hfcteac/Graduation-project-Design-of-intelligent-building-security-system-based-on-STM32-cloud-platform-2/README.md

# Graduation-project-Design-of-intelligent-building-security-system-based-on-STM32-cloud-platform-2
C:\Users\hafeizhou\Desktop\jswjj\Graduation-project-Design-of-intelligent-building-security-system-based-on-STM32-cloud-platform-2
