hfcteac/Graduation-project-Design-of-intelligent-building-security-system-based-on-STM32-cloud-platform-2/face/5B接线图.png

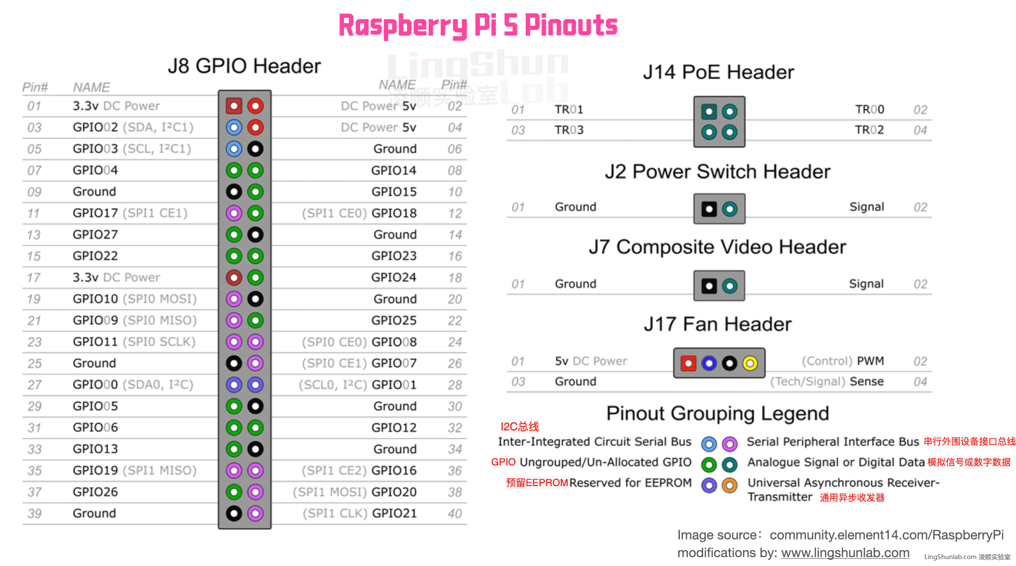
face/5B接线图.png
