hfcteac/Graduation-project-Design-of-intelligent-building-security-system-based-on-STM32-cloud-platform-2/face/known_faces/sn.jpg

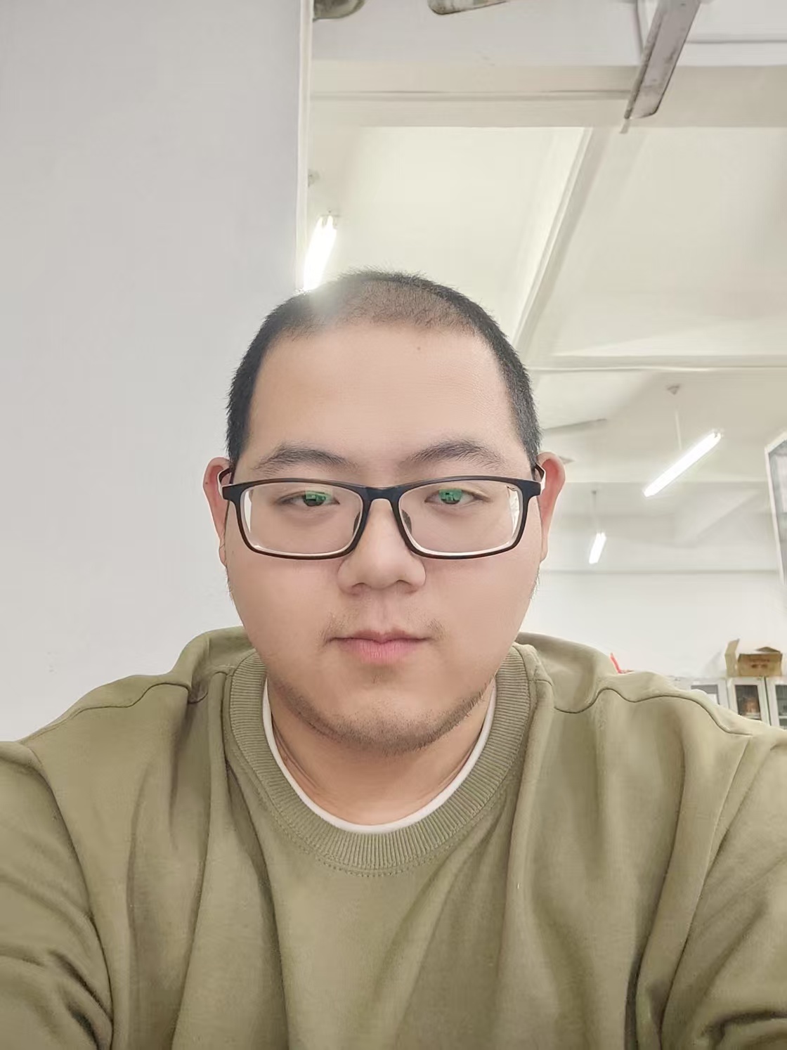
face/known_faces/sn.jpg
