hfcteac/Graduation-project-Design-of-intelligent-building-security-system-based-on-STM32-cloud-platform-2/vet6/44c06ee67584bbd57bad9b7da9e677ca.jpg

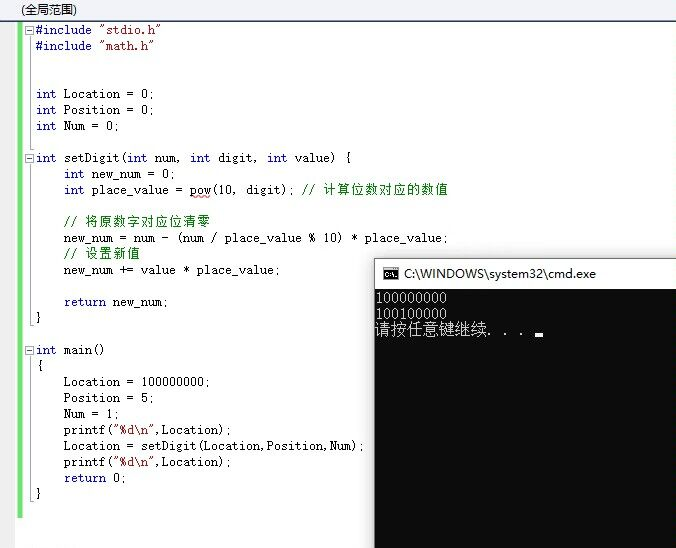
vet6/44c06ee67584bbd57bad9b7da9e677ca.jpg
