hfcteac/Graduation-project-Design-of-intelligent-building-security-system-based-on-STM32-cloud-platform-2/vet6/GCLQ(KQY%EE(XPK2@BC}B]3.png

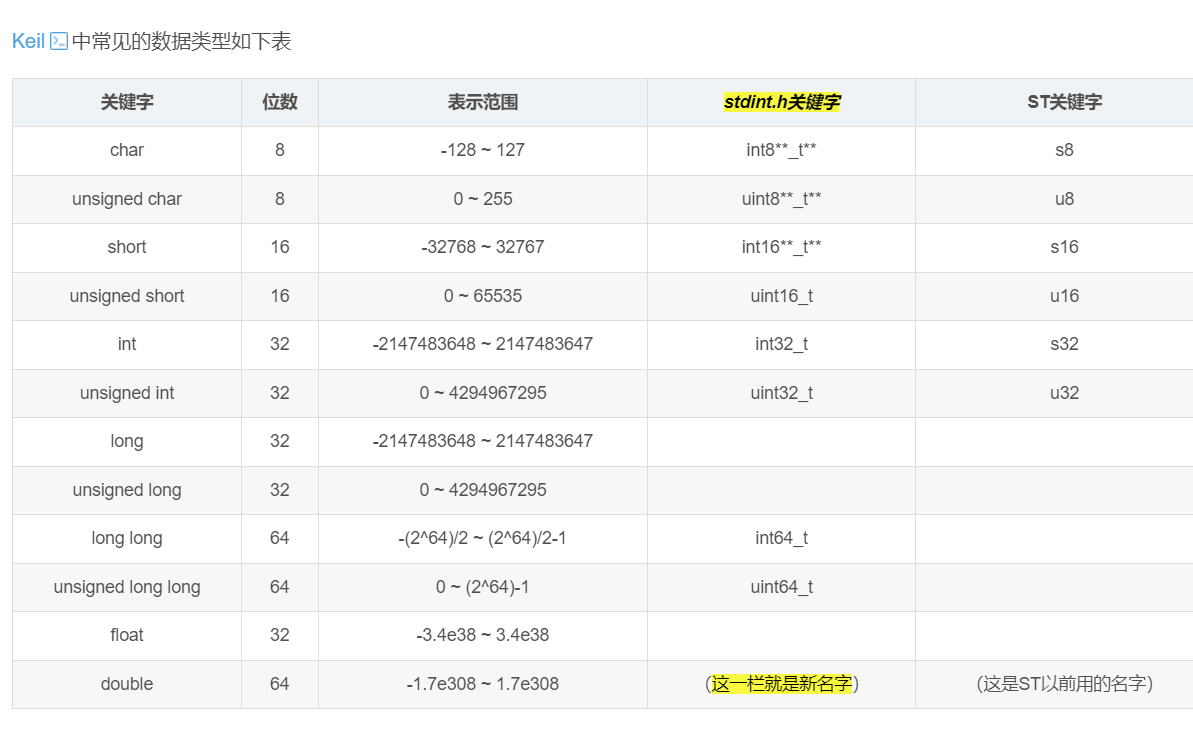
vet6/GCLQ(KQY%EE(XPK2@BC}B]3.png
