hfcteac/Graduation-project-Design-of-intelligent-building-security-system-based-on-STM32-cloud-platform-2/vet6/oeld取模.png

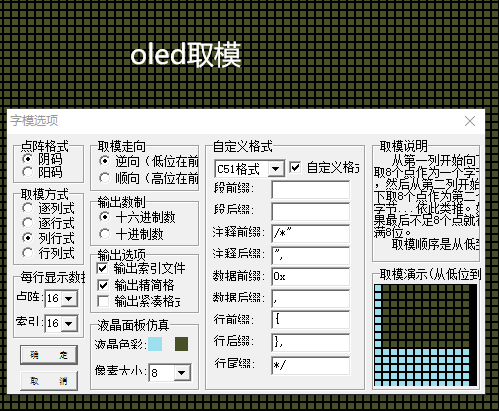
vet6/oeld取模.png
