hfcteac/Graduation-project-Design-of-intelligent-building-security-system-based-on-STM32-cloud-platform-2/wifi云端/wifi/3768a595ddcc4c190060c165a9f5f451.jpg

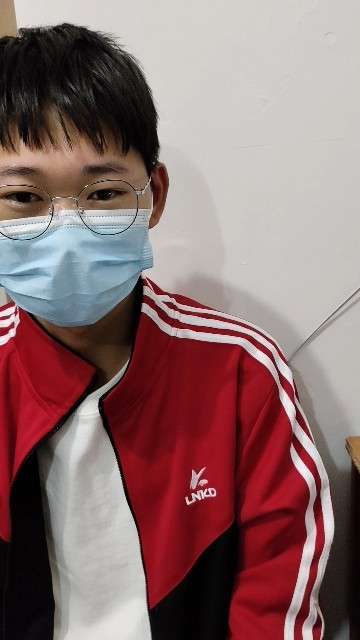
wifi云端/wifi/3768a595ddcc4c190060c165a9f5f451.jpg
