hfcteac/Graduation-project-Design-of-intelligent-building-security-system-based-on-STM32-cloud-platform-2/逆变波形截图/RigolDS3.png

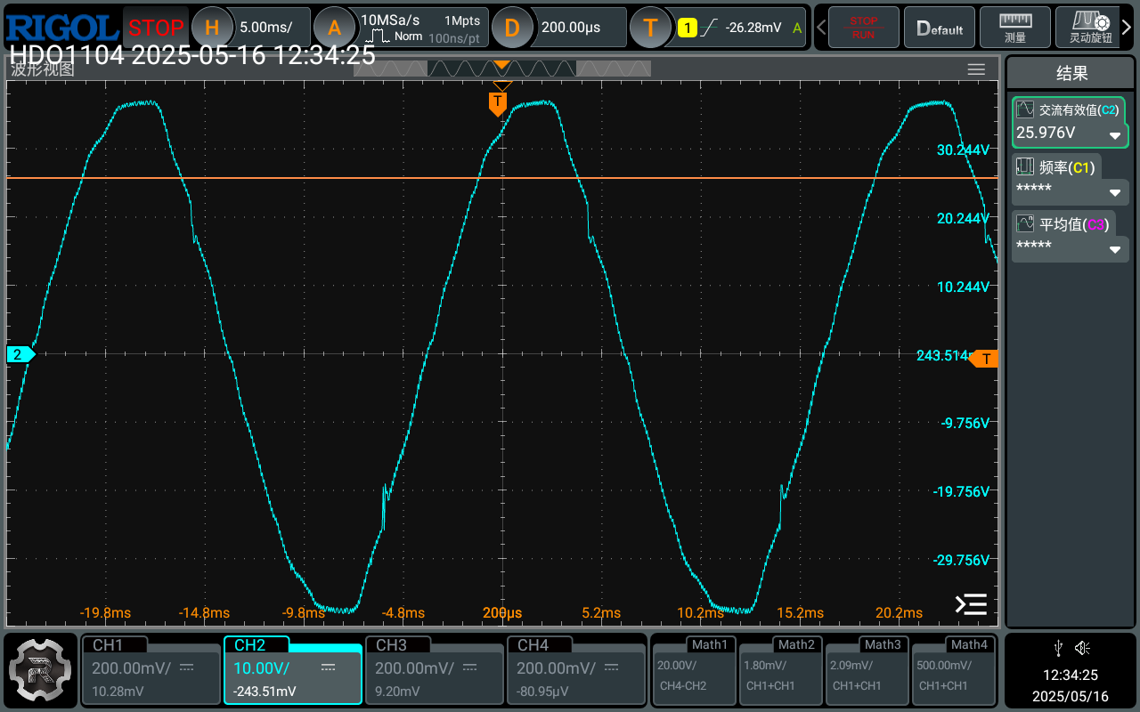
逆变波形截图/RigolDS3.png
