hfcteac/Graduation-project-Design-of-intelligent-building-security-system-based-on-STM32-cloud-platform-2/初稿查重节点/宋楠论文/图/SCH_刷卡指纹人脸2合1_2025-05-30.pdf

# oled显示电路

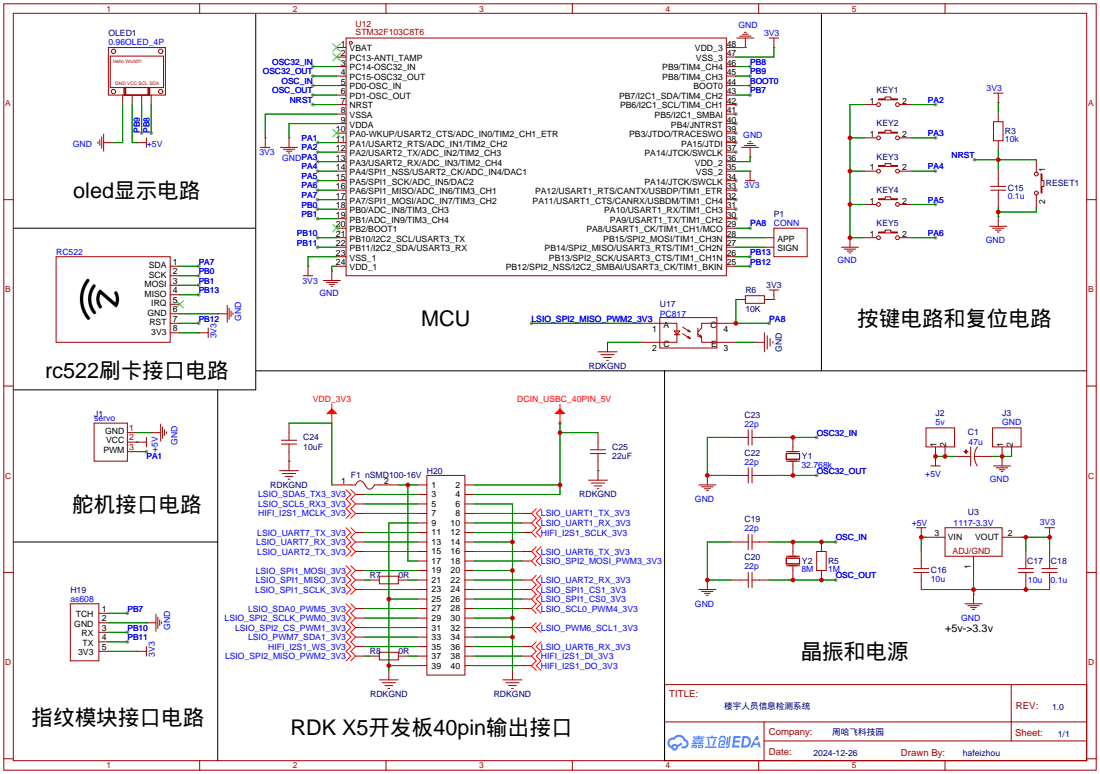
[picture p143: page 1]

PB12/SPI2_NSS/I2C2_SMBAl/USART3_CK/TIM1_BKIN 25 PB13/SPI2_SCK/USART3_CTS/TIM1_CH1N 26 PB14/SPI2_MISO/USART3_RTS/TIM1_CH2N 27 PB15/SPI2_MOSI/TIM1_CH3N 28 PA8/USART1_CK/TIM1_CH1/MCO 29 PA9/USART1_TX/TIM1_CH2 30 PA10/USART1_RX/TIM1_CH3 31 PA11/USART1_CTS/CANRX/USBDM/TIM1_CH4 32 PA12/USART1_RTS/CANTX/USBDP/TIM1_ETR 33 PA14/JTCK/SWCLK 34 VSS_2 35 VDD_2 36 PA14/JTCK/SWCLK 37 PA15/JTDI 38 PB3/JTDO/TRACESWO 39 PB4/JNTRST 40 PB5/I2C1_SMBAl 41 PB6/I2C1_SCL/TIM4_CH1 42 PB7/I2C1_SDA/TIM4_CH2 43 BOOT0 44 PB8/TIM4_CH3 45 PB9/TIM4_CH4 46 VSS_3 47 VDD_3 48

GND VCC SCL SDA
