hfcteac/Graduation-project-Design-of-intelligent-building-security-system-based-on-STM32-cloud-platform-2/初稿查重节点/宋楠论文/图/SCH_核心板_2025-05-30.pdf

# DC5V PLAYE

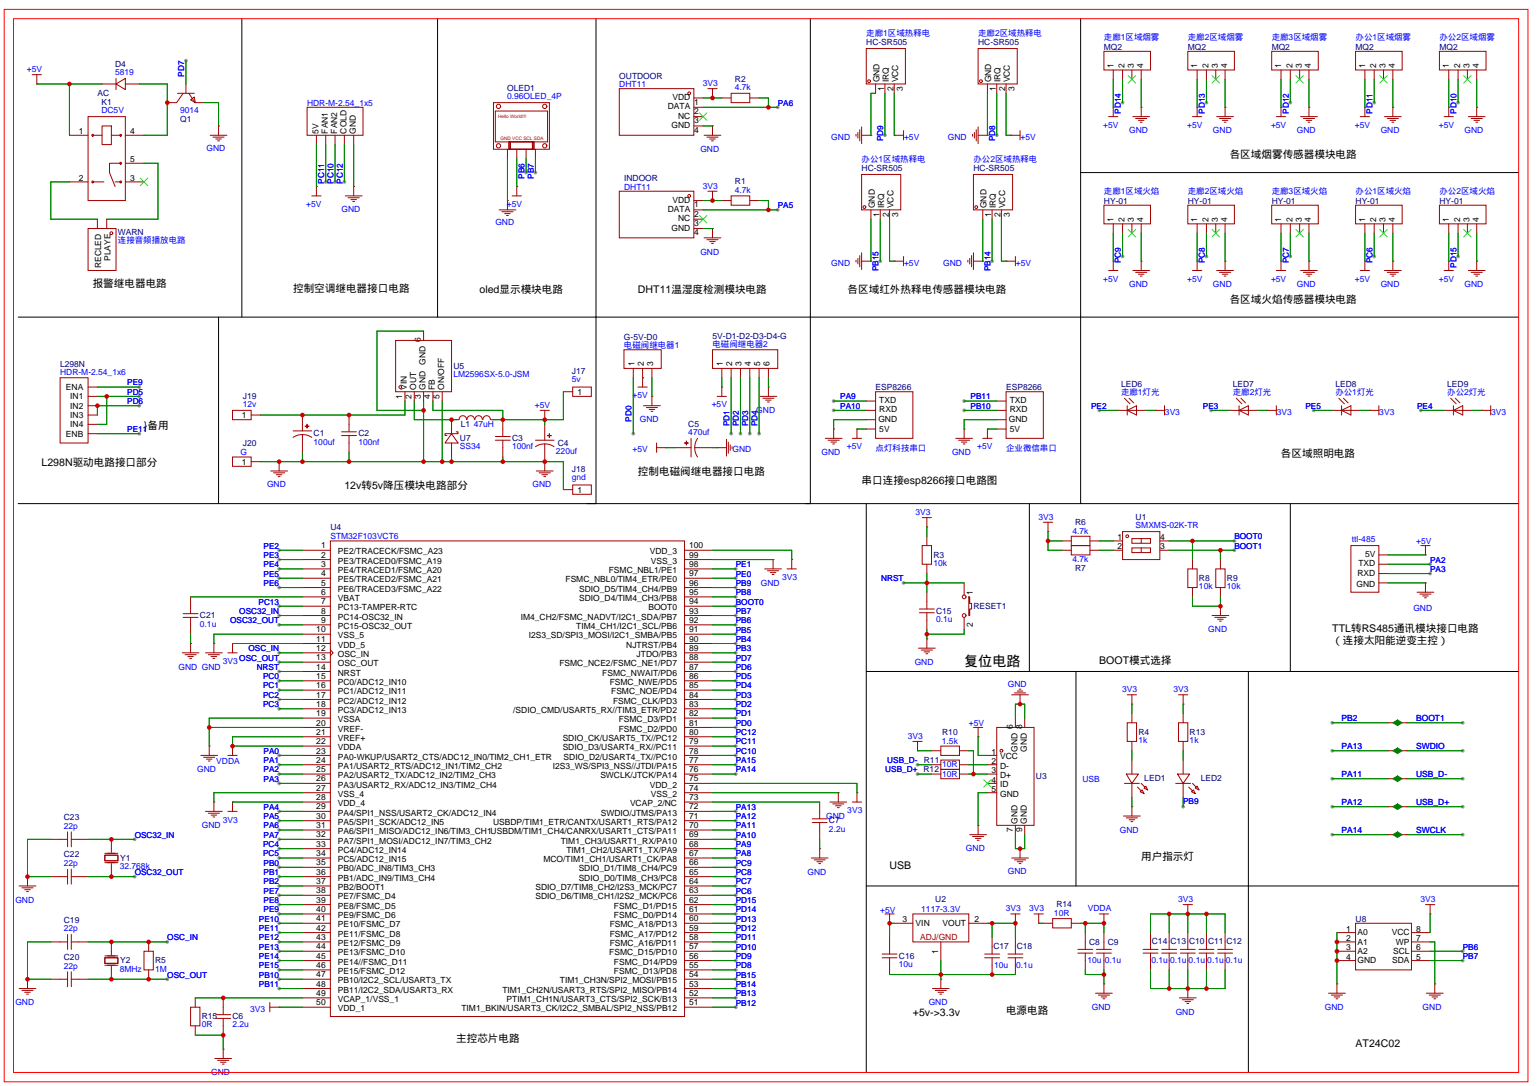
[picture p144: page 1]

GND VCC SCL SDA

SWCLK/JTCK/PA14 76 I2S3_WS/SPI3_NSS//JTDI/PA15 77 SDIO_D2/USART4_TX//PC10 78 SDIO_D3/USART4_RX//PC11 79 SDIO_CK/USART5_TX//PC12 80 FSMC_D2/PD0 81 FSMC_D3/PD1 82 /SDIO_CMD/USART5_RX//TIM3_ETR/PD2 83 FSMC_CLK/PD3 84 FSMC_NOE/PD4 85 FSMC_NWE/PD5 86 FSMC_NWAIT/PD6 87 FSMC_NCE2/FSMC_NE1/PD7 88 JTDO/PB3 89 NJTRST/PB4 90 I2S3_SD/SPI3_MOSI/I2C1_SMBA/PB5 91 TIM4_CH1/I2C1_SCL/PB6 92 IM4_CH2/FSMC_NADVT/I2C1_SDA/PB7 93 BOOT0 94 SDIO_D4/TIM4_CH3/PB8 95 SDIO_D5/TIM4_CH4/PB9 96 FSMC_NBL0/TIM4_ETR/PE0 97 FSMC_NBL1/PE1 98

MCO/TIM1_CH1/USART1_CK/PA8 67 TIM1_CH2/USART1_TX/PA9 68 TIM1_CH3/USART1_RX/PA10 69 USBDM/TIM1_CH4/CANRX/USART1_CTS/PA11 70 USBDP/TIM1_ETR/CANTX/USART1_RTS/PA12 71
