hfcteac/Graduation-project-Design-of-intelligent-building-security-system-based-on-STM32-cloud-platform-2/(notices)

Notices in the files:
vet6/Core/Src/main.c:
Copyright (c) 2024 STMicroelectronics.
All rights reserved.
