hfcteac/Graduation-project-Design-of-intelligent-building-security-system-based-on-STM32-cloud-platform-2/lisiyu.jpg

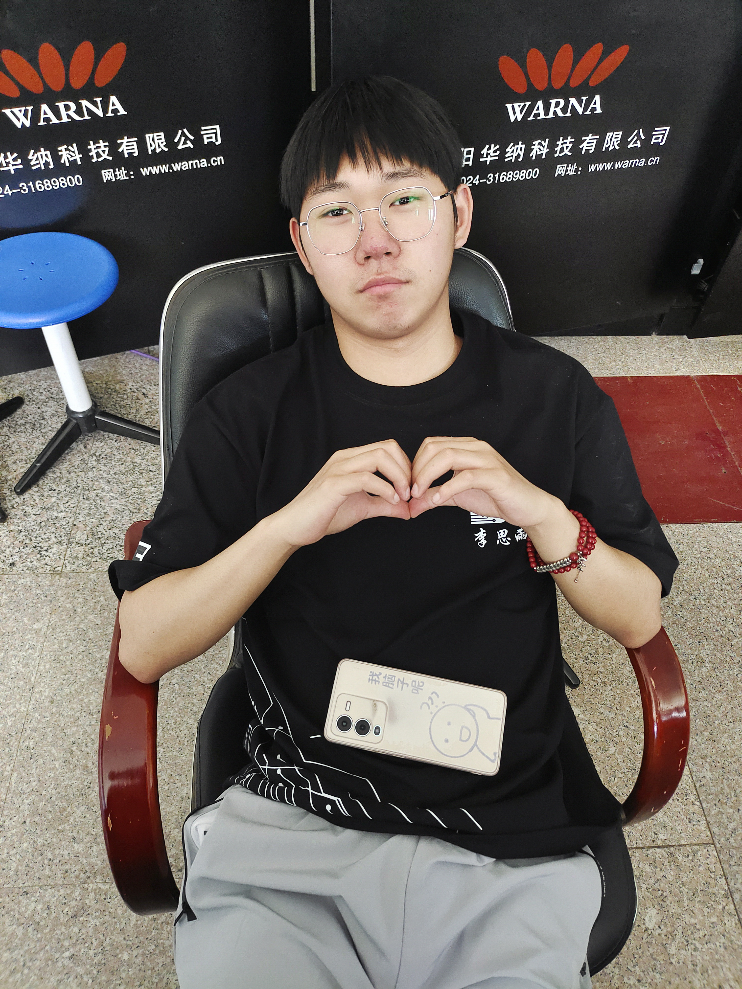
lisiyu.jpg
